OPEnSLab-OSU/PiedPiper/README.md

# PiedPiper
Click [here](https://github.com/OPEnSLab-OSU/OPEnS-Lab-Home/wiki/Pied-Piper) for the full Pied Piper Wiki
