OPEnSLab-OSU/PiedPiper/Hardware/PCB/Preview Materials/PCB.png

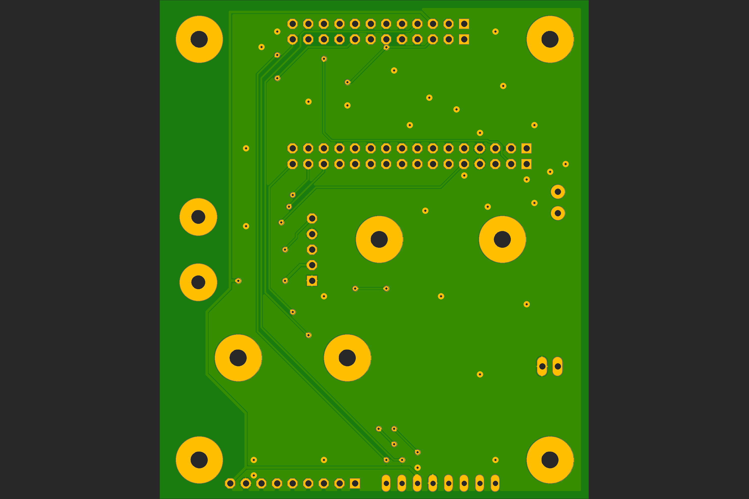
Hardware/PCB/Preview Materials/PCB.png
