OPEnSLab-OSU/PiedPiper/Hardware/PCB/Preview Materials/Top.png

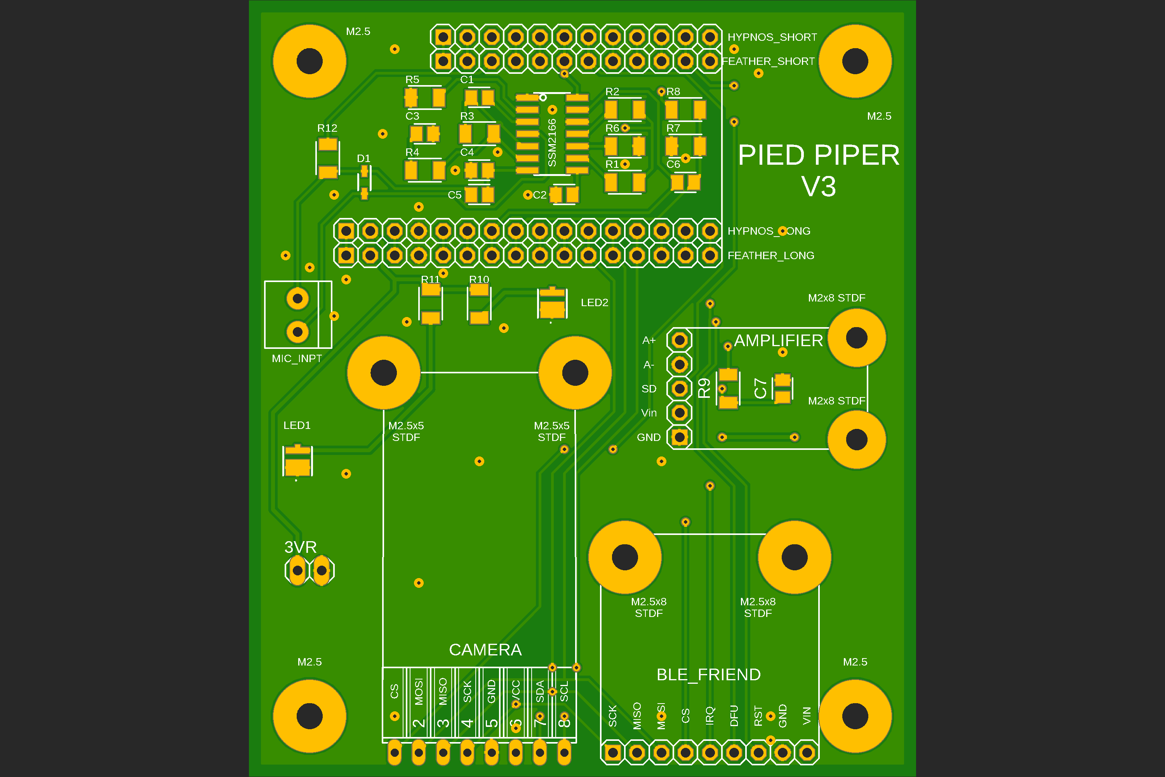
Hardware/PCB/Preview Materials/Top.png
