OPEnSLab-OSU/PiedPiper/Hardware/CAD/STL/MountingPlate.stl

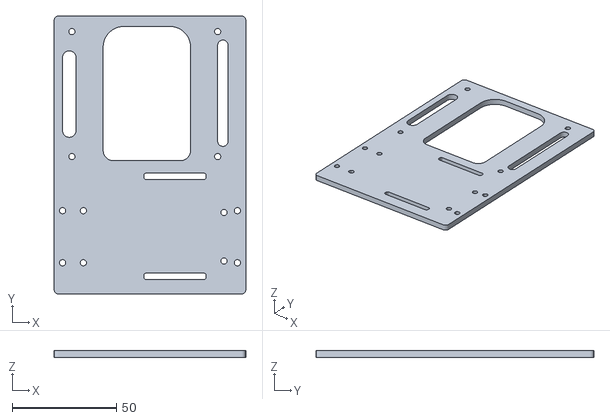
[picture p3: CAD file, 2024-03-12]
Hardware/CAD/STL/MountingPlate.stl
92.0 x 133.5 x 3.18
