OPEnSLab-OSU/PiedPiper/Hardware/CAD/STL/CameraShield.stl

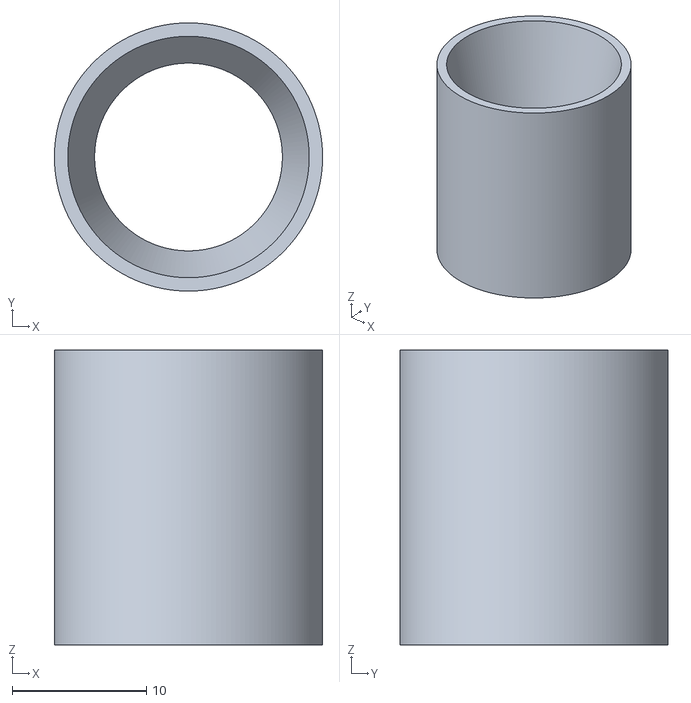
[picture p4: CAD file, 2024-03-12]
Hardware/CAD/STL/CameraShield.stl
20.0 x 20.0 x 22.0
