OPEnSLab-OSU/PiedPiper/(list of files, cad)

Other CAD files:
Hardware/CAD/DXF/ImagingBoxPattern.dxf
Hardware/CAD/CameraShield.f3d
Hardware/CAD/ImagingBox.f3d
Hardware/CAD/MountingPlate.f3d
Hardware/CAD/VibrationExciterLoop.f3d
