OPEnSLab-OSU/PiedPiper/Hardware/PCB/Preview Materials/Schematic.pdf

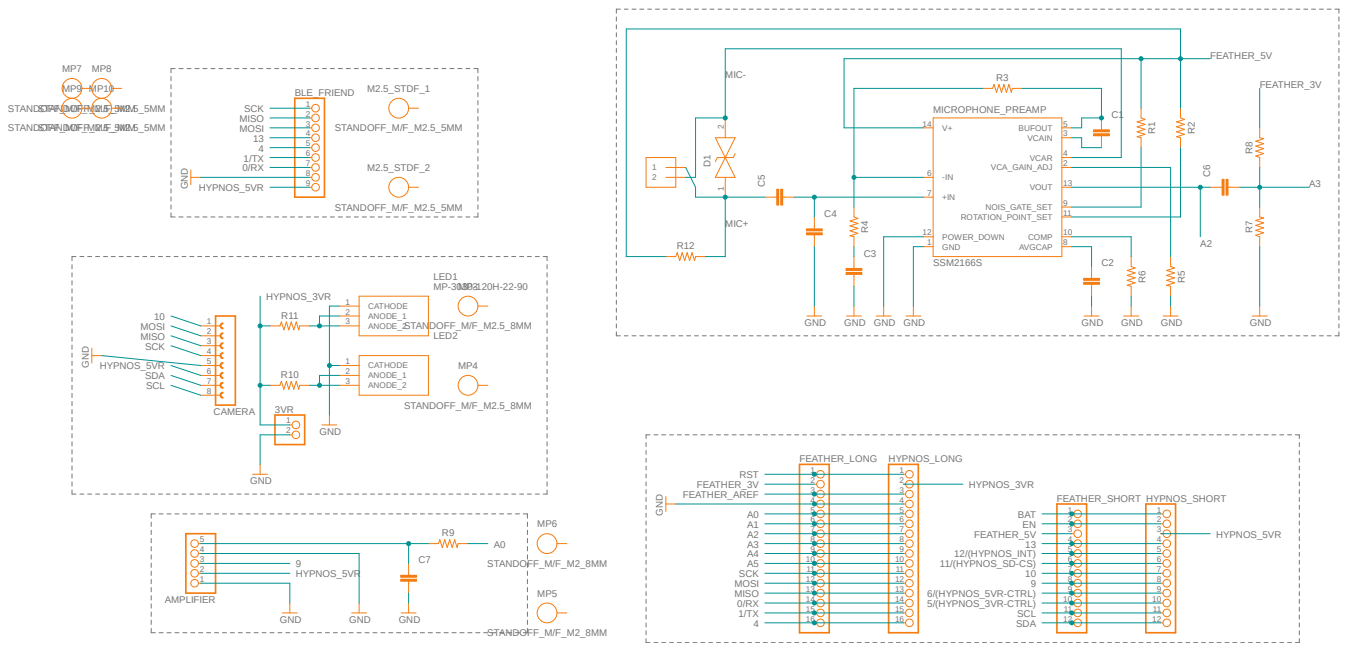
[picture p5: page 1]
