OPEnSLab-OSU/PiedPiper/Hardware/PCB/PiedPiperPCB.brd

## EAGLE design Hardware/PCB/PiedPiperPCB.brd (2022-05-09)

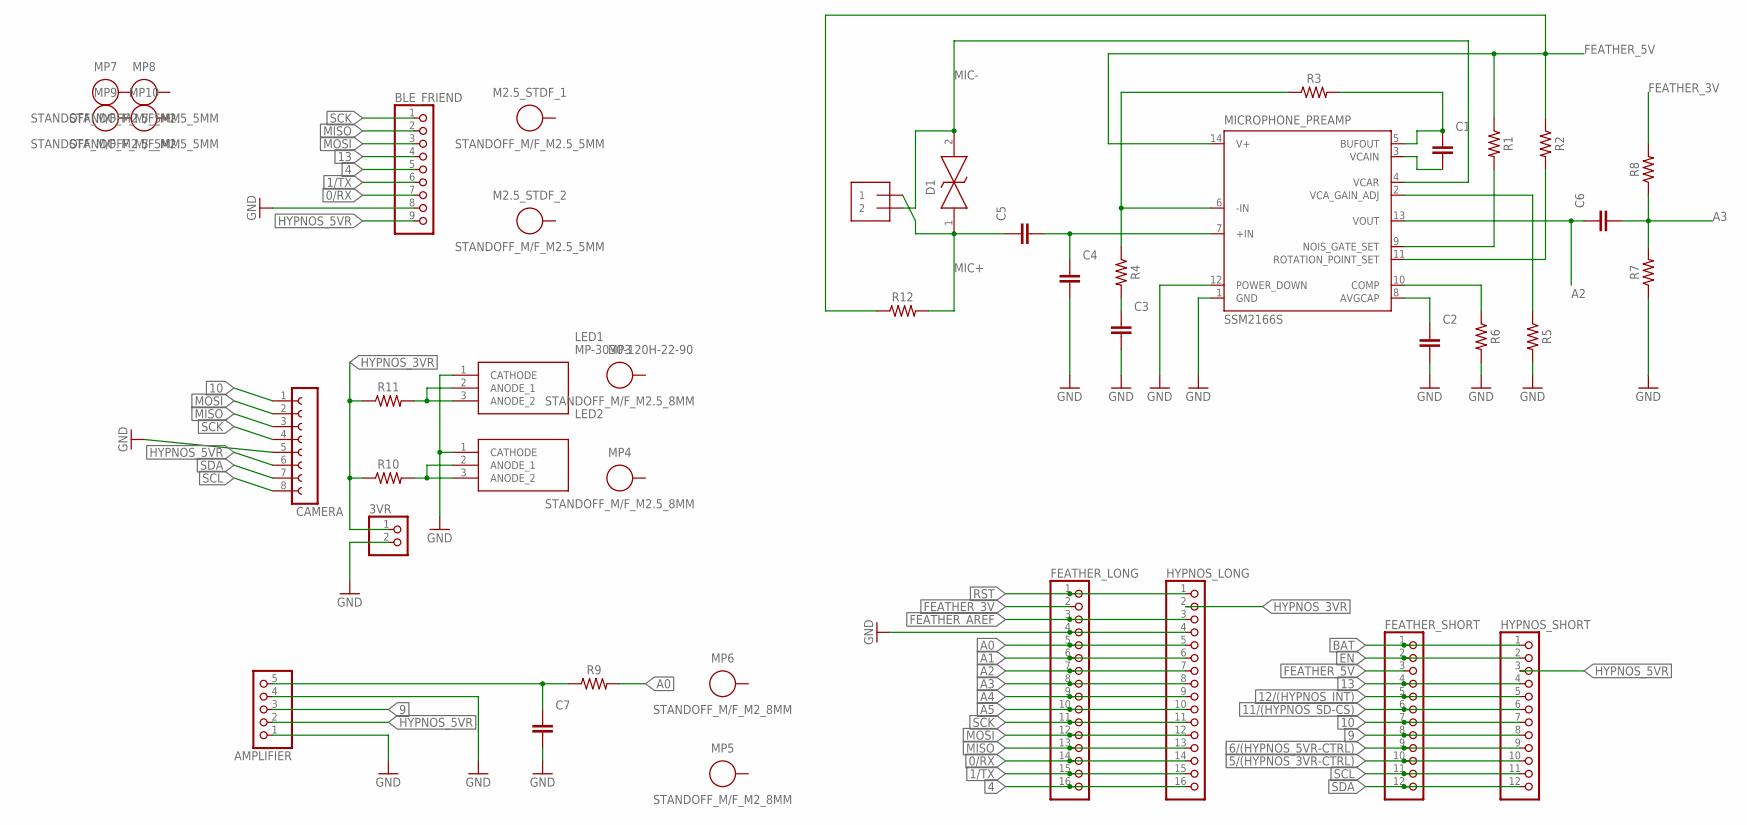
[picture p6: schematic PiedPiperSchematic.sch]

Parts:
3VR: PINHD-1X2; 1X02
AMPLIFIER: PINHD-1X05_2.54-S; 1X05-S
BLE_FRIEND: PINHD-1X09_2.54-S; 1X09-S
C1, C2, C3, C4, C5, C6, C7: C_CHIP-0805(2012-METRIC); CAPC2012X110
CAMERA: FE08W
D1: STS321033B100; SOD2613X100N
FEATHER_LONG: PINHD-1X16_2.54-S; 1X16-S
FEATHER_SHORT: PINHD-1X12_2.54-S; 1X12-S
HYPNOS_LONG: PINHD-1X16_2.54-S; 1X16-S
HYPNOS_SHORT: PINHD-1X12_2.54-S; 1X12-S
LED1, LED2: MP-3030-120H-22-90; MP3030120H2290
M2.5_STDF_1, M2.5_STDF_2: STANDOFF_M/F_M2.5_5MM; STANDOFF_HEX_MALE-FEMALE_500X500_M2.5X0.45_MTGP755H270
MICROPHONE_PREAMP: SSM2166S; SO14
MIC_INPT: 1X2-3.5MM
MP3, MP4: STANDOFF_M/F_M2.5_8MM; STANDOFF_HEX_MALE-FEMALE_500X800_M2.5X0.45_MTGP755H270
MP5, MP6: STANDOFF_M/F_M2_8MM; STANDOFF_HEX_MALE-FEMALE_400X800_M2X0.4_MTGP600H220
MP7, MP8, MP9, MP10: STANDOFF_M/F_M2.5_5MM; STANDOFF_HEX_MALE-FEMALE_500X500_M2.5X0.45_MTGP755H270
R1, R2, R3, R4, R5, R6, R7, R8, R9, R10, R11, R12: R-US_CHIP-1206(3216-METRIC); RESC3216X70

Connections:
0/RX: BLE_FRIEND.7, FEATHER_LONG.14, HYPNOS_LONG.14
1/TX: BLE_FRIEND.6, FEATHER_LONG.15, HYPNOS_LONG.15
4: BLE_FRIEND.5, FEATHER_LONG.16, HYPNOS_LONG.16
5/(HYPNOS_3VR-CTRL): FEATHER_SHORT.10, HYPNOS_SHORT.10
6/(HYPNOS_5VR-CTRL): FEATHER_SHORT.9, HYPNOS_SHORT.9
9: AMPLIFIER.3, FEATHER_SHORT.8, HYPNOS_SHORT.8
10: CAMERA.1, FEATHER_SHORT.7, HYPNOS_SHORT.7
11/(HYPNOS_SD-CS): FEATHER_SHORT.6, HYPNOS_SHORT.6
12/(HYPNOS_INT): FEATHER_SHORT.5, HYPNOS_SHORT.5
13: BLE_FRIEND.4, FEATHER_SHORT.4, HYPNOS_SHORT.4
A0: FEATHER_LONG.5, HYPNOS_LONG.5, R9.2
A1: FEATHER_LONG.6, HYPNOS_LONG.6
A2: C6.1, FEATHER_LONG.7, HYPNOS_LONG.7, MICROPHONE_PREAMP.13 (VOUT)
A3: C6.2, FEATHER_LONG.8, HYPNOS_LONG.8, R7.2, R8.1
A4: FEATHER_LONG.9, HYPNOS_LONG.9
A5: FEATHER_LONG.10, HYPNOS_LONG.10
AVGCAP: C2.1, MICROPHONE_PREAMP.8 (AVGCAP)
BAT: FEATHER_SHORT.1, HYPNOS_SHORT.1
BUFOUT: C1.1, MICROPHONE_PREAMP.5 (BUFOUT), R3.2
COMP: MICROPHONE_PREAMP.10 (COMP), R6.1
EN: FEATHER_SHORT.2, HYPNOS_SHORT.2
FEATHER_3V: FEATHER_LONG.2, R8.2
FEATHER_5V: FEATHER_SHORT.3, MICROPHONE_PREAMP.14 (V+), R1.1, R2.1, R12.1
FEATHER_AREF: FEATHER_LONG.3, HYPNOS_LONG.3
GND: 3VR.2, AMPLIFIER.1, AMPLIFIER.4, BLE_FRIEND.8, C2.2, C3.2, C4.2, C7.2, CAMERA.5, FEATHER_LONG.4, HYPNOS_LONG.4, LED1.1 (CATHODE), LED2.1 (CATHODE), MICROPHONE_PREAMP.1 (GND), MICROPHONE_PREAMP.12 (POWER_DOWN), R5.2, R6.2, R7.1
HYPNOS_3VR: 3VR.1, HYPNOS_LONG.2, R10.1, R11.1
HYPNOS_5VR: AMPLIFIER.2, BLE_FRIEND.9, CAMERA.6, HYPNOS_SHORT.3
IN+: C4.1, C5.2, MICROPHONE_PREAMP.7 (+IN)
IN-: MICROPHONE_PREAMP.6 (-IN), R3.1, R4.1
MIC+: C5.1, D1.1, MIC_INPT.1, R12.2
MIC-: D1.2, MICROPHONE_PREAMP.4 (VCAR), MIC_INPT.2
MISO: BLE_FRIEND.2, CAMERA.3, FEATHER_LONG.13, HYPNOS_LONG.13
MOSI: BLE_FRIEND.3, CAMERA.2, FEATHER_LONG.12, HYPNOS_LONG.12
unnamed: LED1.2 (ANODE_1), LED1.3 (ANODE_2), R11.2
unnamed: C3.1, R4.2
unnamed: AMPLIFIER.5, C7.1, R9.1
unnamed: LED2.2 (ANODE_1), LED2.3 (ANODE_2), R10.2
RGAIN: MICROPHONE_PREAMP.2 (VCA_GAIN_ADJ), R5.1
RNOISE: MICROPHONE_PREAMP.9 (NOIS_GATE_SET), R1.2
RROT: MICROPHONE_PREAMP.11 (ROTATION_POINT_SET), R2.2
RST: FEATHER_LONG.1, HYPNOS_LONG.1
SCK: BLE_FRIEND.1, CAMERA.4, FEATHER_LONG.11, HYPNOS_LONG.11
SCL: CAMERA.8, FEATHER_SHORT.11, HYPNOS_SHORT.11
SDA: CAMERA.7, FEATHER_SHORT.12, HYPNOS_SHORT.12
VCAIN: C1.2, MICROPHONE_PREAMP.3 (VCAIN)

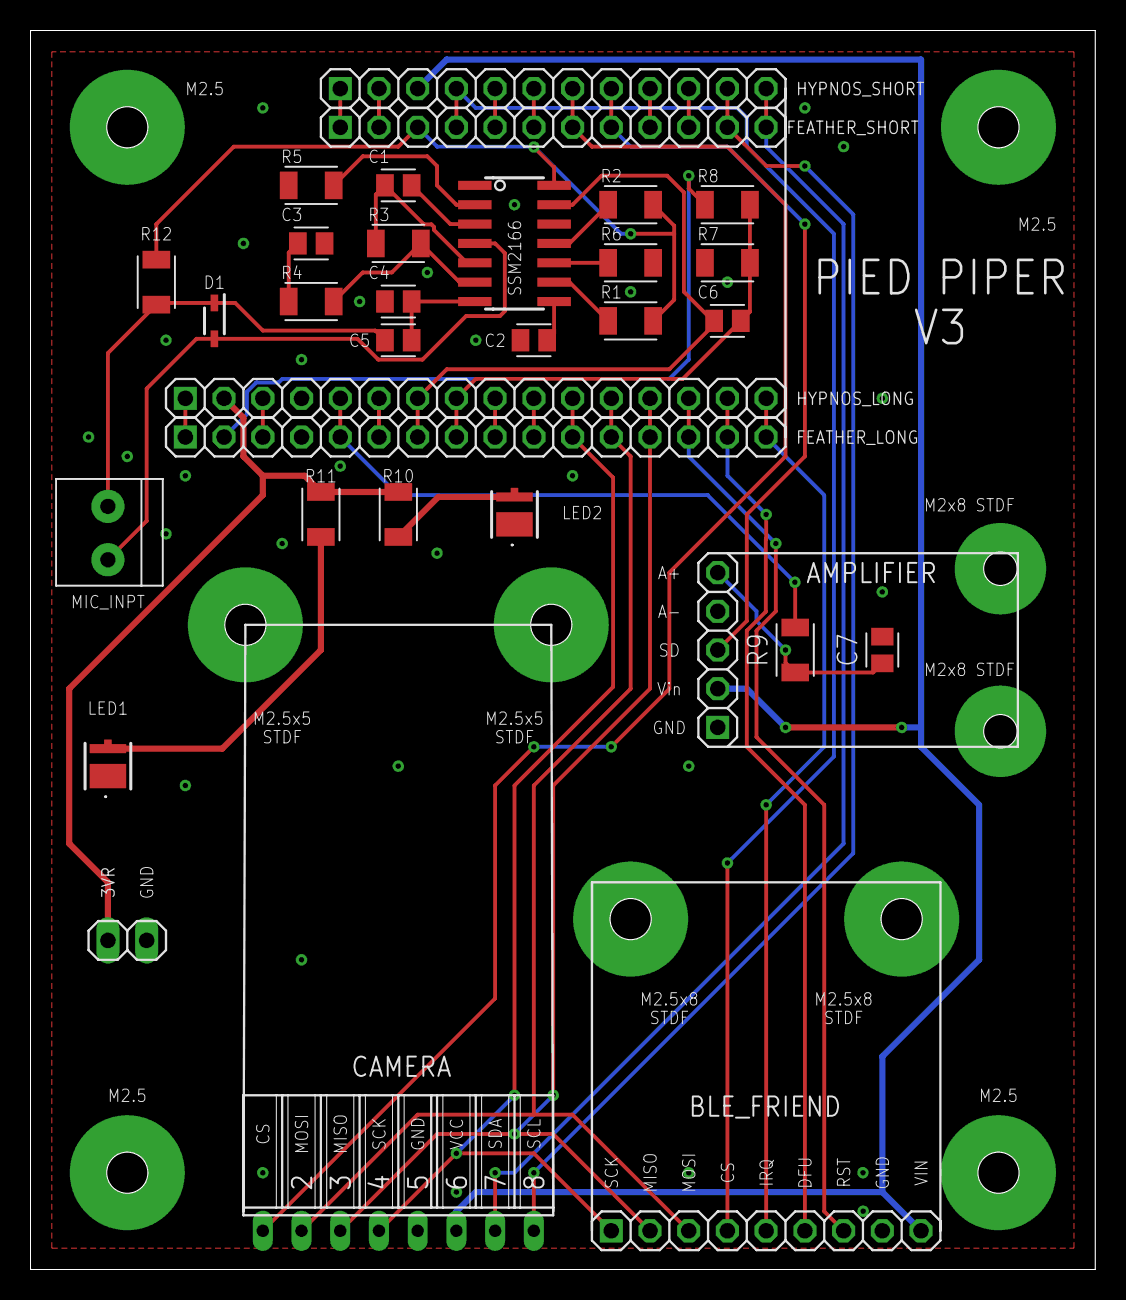
[picture p7: board PiedPiperPCB.brd from above]

Board: 2 copper layers, 69.8 x 81.3 mm, 42 parts (0 on the bottom side), 45 nets.
