OPEnSLab-OSU/PiedPiper/(commit log)

2019-11-12 Added Pied Piper 3D Models
    [PiedPiperLRA v8.f3d]
2019-11-12 Added Pied Piper PCB Board
    [PiedPiper.brd]
2019-11-12 Added Pied Piper Schematic
    [PiedPiper.sch]
2019-11-22 Added Contact Mic 3D model
    [PiedPiper Contact Mic Housing v8.f3d]
2020-01-27 Fixed a bug in detection algorithm
    [piedPiper.cpp, piedPiper.h]
2020-04-30 Changed contact mic design
    New design gives the contact mic a stronger hold and uses less filament when printing
    [PiedPiper Contact Mic Housing v8.f3d]
2020-06-15 Updated Pied Piper Trap STL files
    [Insect Containment.stl, Insect Entrance.stl, SpeakerAttachment.stl, Top Hook.stl]
2020-07-27 Fixed RTC/SD issue, added operation modes
    Adopted code to new PCB with shutdown for MAX9477 amplifier, added different operational modes(Full,No Playback, Gain Calibration, Audio Playback)
2020-11-05 Added updated PCB
    [PiedPiper.brd, PiedPiper.sch]
2020-11-09 Create STL
2020-11-10 Moved STL into folder
    [Insect Containment.stl, Insect Entrance.stl, MicHouse.stl, Press.stl, SpeakerAttachment.stl, Top Hook(Print Twice).stl]
2021-07-23 Added camera support
    The camera used pin 10 for power control and pin 7 for imaging control
2021-08-06 Updated to reflect new hardware changes
    Camera power and imaging control pins have been remapped.
2021-08-09 Added status report log
    It's now easier to tell when problems occur (if any), because the system will periodically record whether or not it is alive, to the text file "Log.txt"
    [piedPiper.cpp, piedPiper.h]
2021-08-18 Detection algorithm improved
    The detection algorithm is now less likely to output a false positive in response to intense transient noise.
    [piedPiper.cpp, piedPiper.h]
2021-08-26 Updated PCB
2021-08-26 Added preview materials
    PDF and PNG files of the schematic and PCB have been added.
    [PiedPiper.brd, PiedPiper.sch, PiedPiper_Camera_PCB v62.f3z]
2021-08-26 Reorganized files
    [PiedPiper_Camera_PCB_v39.sch, PiedPiper_Camera_PCB_v51.brd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]
2021-08-27 Revised PCB
    Removed unnecessary ground traces, slightly reduced lengths of 5VR and 3VR traces, and added wire labels to camera connector pads.
    [PiedPiper_Camera_PCB v62.f3z, PiedPiper_Camera_PCB v67.f3z, PiedPiper_Camera_PCB_v42.sch, PiedPiper_Camera_PCB_v51.brd, PiedPiper_Camera_PCB_v55.brd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]
2021-08-27 Another PCB revision
    Uploaded new PCB revision (in collaboration with Bryson) which includes ground plane vias to reduce capacitance.
    [PiedPiper_Camera_PCB v56.brd, PiedPiper_Camera_PCB v67.f3z, PiedPiper_Camera_PCB v68.f3z, PiedPiper_Camera_PCB_v43.sch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]
2021-09-06 Added camera housing CAD files; fixed bug
    [HousingBack.step, HousingBack.stl, HousingFront.step, HousingFront.stl, HousingMid.f3d, HousingMid.step, HousingMid.stl]
2021-09-07 Reorganized files and added sample printing utility
2021-09-07 Updated CAD files
    [ContactMicHousing.stl, HousingBack.stl, HousingFront.stl, VibrationExciterAttachment.stl]
2021-09-08 Fixed bug
    Added correct hypnos pin configuration to waveform viewer utility
    [piedPiper.cpp, piedPiper.h, samplePrint.ino]
2021-09-08 Added pre-arranged parts file for 3D printing.
    [AllParts.stl]
2021-09-08 Added correct playback number for Hypnos
    [samplePrint.ino]
2021-09-11 Updated arranged parts file
    [AllParts.stl, VibrationExciterAttachment.stl]
2021-09-19 Fixed takePhoto
    Pin configuration commands were mistakenly commented out
    [piedPiper.cpp, samplePrint.ino]
2021-12-27 Minor refactoring
    [MembraneBracket.stl, VibrationExciterAttachment.stl, VibrationExciterBase.stl, VibrationExciterParts.stl]
2022-05-09 Removed files that were deleted from camera branch
2022-05-09 Added new PCB files
    [PCB v113.brd, PiedPiper_Camera_PCB v56.brd, PiedPiper_Camera_PCB v68.f3z, PiedPiper_Camera_PCB_v43.sch, Schematic_v39.sch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]
2022-05-09 Added labels to 3VR pads
    [PiedPiperPCB.brd, PiedPiperSchematic.sch]
2022-05-09 Fixed schematic and PCB version issue
    [PiedPiperPCB.brd, PiedPiperSchematic.sch]
2022-05-12 Updated CAM files
    [copper_bottom.gbr, copper_top.gbr, drill_1_16.xln, gerber_job.gbrjob, profile.gbr, silkscreen_bottom.gbr, silkscreen_top.gbr, soldermask_bottom.gbr]
2023-06-27 Added ArduinoFFTFloat dependency
2023-07-07 Reorganized files & added some utilities
    [AllParts.stl, ContactMicHousing.stl, HousingBack.step, HousingBack.stl, HousingFront.step, HousingFront.stl, HousingMid.f3d, HousingMid.step]
2024-03-05 Minor refactoring
    Changed significance threshold value to something that won't change depending on the FFT size.
    [PiedPiper.ino, piedPiper.cpp, piedPiper.h]
2024-03-12 Updated CAD Files
    Updated CAD Files
    [AllParts.stl, CameraShield.f3d, CameraShield.stl, ContactMicHousing.stl, HousingBack.step, HousingBack.stl, HousingFront.step, HousingFront.stl]
